moluqitu/2020nianTIbeiFti-2022nianshanxishengdianzishejidasaiEti/(notices)

Notices in the files:
最终版山西省电赛2022E/HARDWARE/MLX90614/mlx90614.h:
Copyright (C), //°æÈ¨
最终版山西省电赛2022E/HARDWARE/KEY/key.c:
Copyright(C) ¹ãÖÝÊÐÐÇÒíµç×Ó¿Æ¼¼ÓÐÏÞ¹«Ë¾ 2009-2019
All rights reserved
